ojasvimukkoti/Embedded-Control-System-for-Soft-Robotic-Crawler/README.md

# Embedded-Control-System-for-Soft-Robotic-Crawler
Research Project done at Northeastern University's Lab PARSEs.

Technical report of the project can be found here: [report](https://github.com/ojasvimukkoti/Embedded-Control-System-for-Soft-Robotic-Crawler/blob/main/Embedded%20Control%20System%20Techincal%20Report.pdf).

## Video Demo of Control System

### Video of 2-step Crawling Sequence with Linux Terminal Outputs
https://github.com/user-attachments/assets/649c25fe-7d4c-467f-b174-4258f3ca5ed1

### Video of 3-step Crawling Sequence
https://github.com/user-attachments/assets/9732efff-cdab-4b4e-b23d-b8be7b90985f
