ojasvimukkoti/Embedded-Control-System-for-Soft-Robotic-Crawler/(commit log)

2026-04-22 Uploaded Arduino test code for system
2026-04-22 Upload wi-fi test code for toggle LED
